brianthornock/DCSC/README.md

# DCSC
DIY PT2399-Based Stereo Tri-Chorus

Full Documentation for this project is found at https://scientificguitarist.wixsite.com/home/diamond-church-street-chorus
